debartan/MiniDox/Minidox Ref Case Files/README.md

# Minidox Files!

The project has been coordinated from Geekhack
([thread here](https://geekhack.org/index.php?topic=89951.msg2435112#msg2435112)), 
and the group buy run through reddit.  The Geekhack link has reddit threads and related discussion.

Files are posted, Video below of me explaning how to put it together.

Assembly youtube video (https://youtu.be/ApG_g-MvKxE)

## Acrylic thicknesses:

* 9mm (~3/8") for High Profile

* 6mm (~1/4") for Upper and Lower Middles

* 3mm (1/8") for Bottom

## Tapping Middles
Either a 1/4"-20 (Imperial) or M6 (Metric) tap will work.
Holes are compatible with either.
My preferred cheap source is Shars.
Links for: [1/4-20](http://www.shars.com/products/cutting/taps/1-4-20nc-taper-hss-standard-hand-tap) and [M6](http://www.shars.com/products/cutting/taps/6x1-0-hss-metric-spiral-point-plug-tap)
The easiest and fastest way I've found to tap is to chuck the tap in a handdrill.  Run the tap forward into the hole (after it's been poked clean of acrylic) until the taper clears.  Usually, you can tell because the drill will run easier after it has completed the thread.  Release the trigger and let the drill stop, then reverse out.  The important thing to remember when tapping is ** keep the tap perpendicular the workpiece! ** I've found keeping in the acrylic stock helps to prevent the middles from snapping or bending too much.

## Tapping High Profiles
It's similar, but a bit trickier because the holes are a lot smaller.
An M2 tap [like this one](http://www.shars.com/products/cutting/taps/m2-x-40-d3-2-flute-spiral-point-plug-tap) is what you'll need.  Make sure the hole is clear, and follow the same proceedure as above. Be careful, as the flute lenght is only a little longer than the acrylic in most cases.
Also of note is how for laser cuttering, it's important to get the hole very close to the needed dimension.  In my earlier testing, telling a laser to cut the right .063" (1.6mm) without cutter compensation made the hole too large for the screw to bite in after tapping.  What I did afterward was undersized the holes in CAD to .055" which worked most of the time.  In some cases, there was still some issues with slippage.  In that case, a little glue in the hole right before you stick the screw in can help.

## Ordering hardware

I've attached my "Assembly Counting" sheets, which are a packing list or the full acrylic or double plate case hardware packs. In the group buy, these came in little ziplok baggies.  The lists include the [McMaster Carr](https://www.mcmaster.com/#) part numbers for what I used.  If you want to make your own, they are probably your best source.  The one exception are the metric tenting screws, which I got from [Allen Fasteners](http://www.allensfasteners.com/detail.asp?Product_ID=70000).

## Plastidipping

Each tenting screw has been plastidipped for skid prevention.  The process is pretty simple, buy the can, dip the screw up until about the square part of neck, and have it dry vertically.  I used the side flaps of a box with a 1/4" hole drilled in them to support the screws.  One coat was plenty thick in my experience.
