debartan/MiniDox/CAD/Renders/Case_Render.JPG

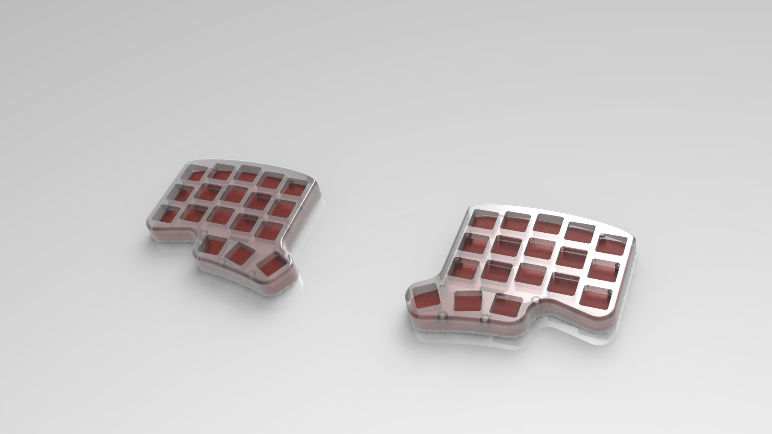
CAD/Renders/Case_Render.JPG
