debartan/MiniDox/CAD/Renders/Case_Render_wCaps.JPG

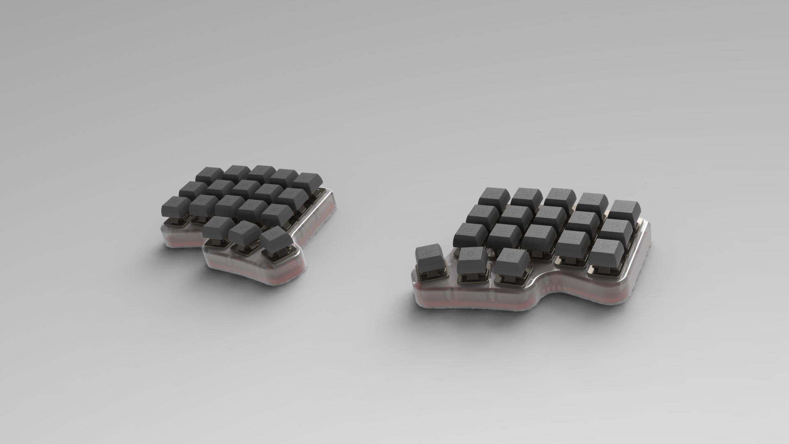
CAD/Renders/Case_Render_wCaps.JPG
