debartan/MiniDox/CAD/Renders/Case_Render_woCaps.JPG

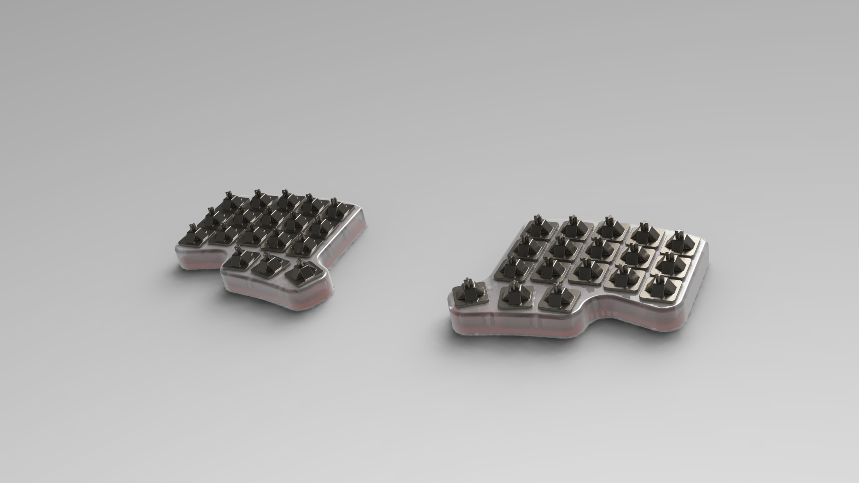
CAD/Renders/Case_Render_woCaps.JPG
