debartan/MiniDox/CAD/STL/FullAssembly - ControllerClipBot-1.STL

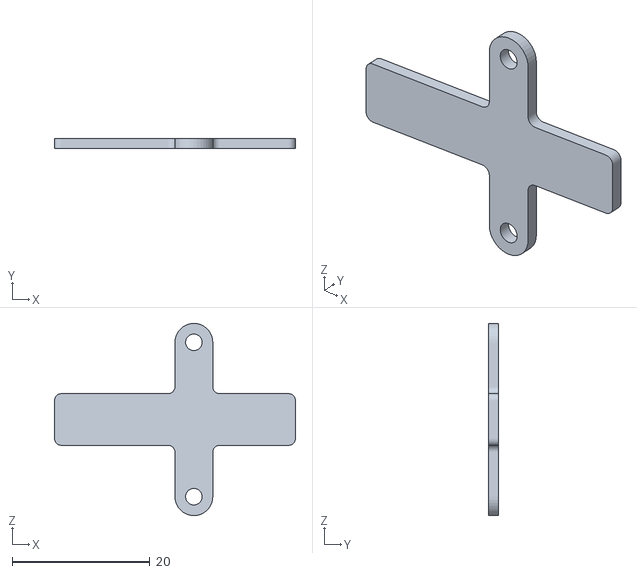
[picture p4: CAD file, 2021-05-11]
CAD/STL/FullAssembly - ControllerClipBot-1.STL
35.0 x 1.50 x 27.9
