debartan/MiniDox/CAD/Test Prints/ControllerFit.SLDASM

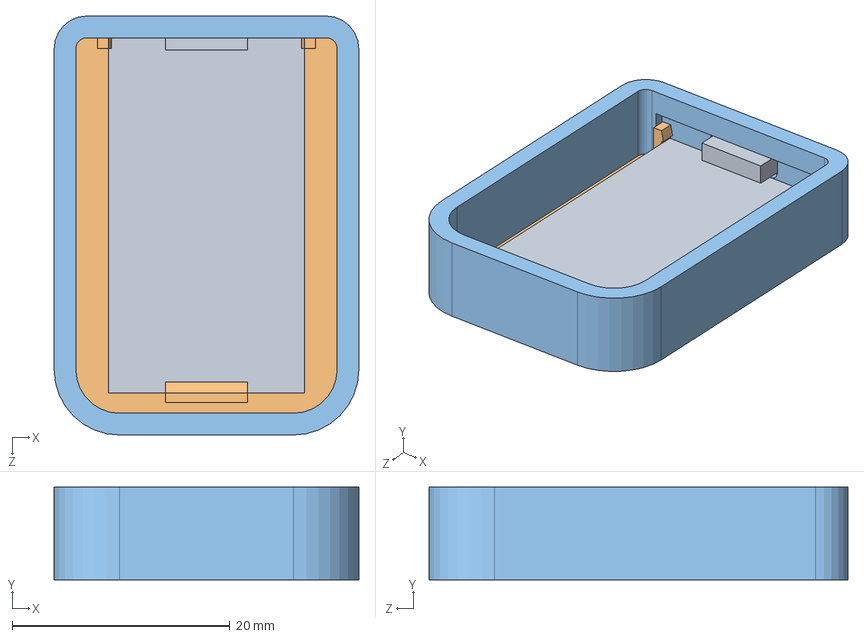
[picture p5: CAD file, 2021-05-11]
CAD/Test Prints/ControllerFit.SLDASM
28.0 x 8.50 x 38.5 mm
Microcontroller
Base^ControllerFit
Housing^ControllerFit
