debartan/MiniDox/CAD/STL/FullAssembly - ControllerClipTop-1.STL

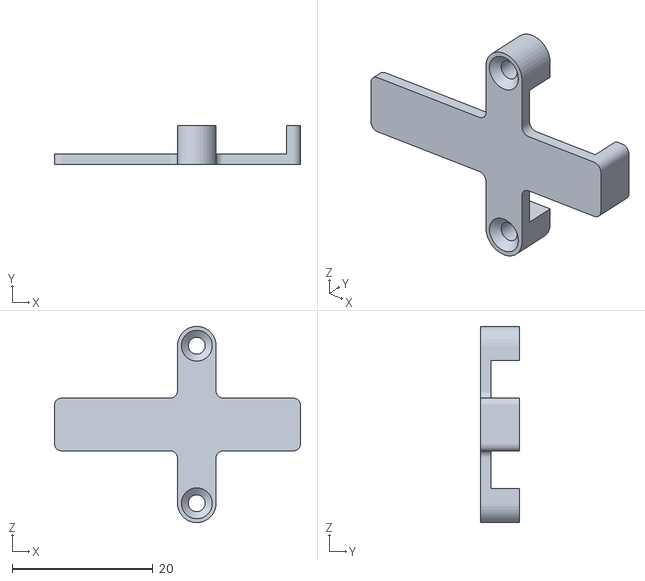
[picture p6: CAD file, 2021-05-11]
CAD/STL/FullAssembly - ControllerClipTop-1.STL
35.0 x 5.50 x 27.9
