debartan/MiniDox/CAD/Test Prints/USBFit.SLDASM

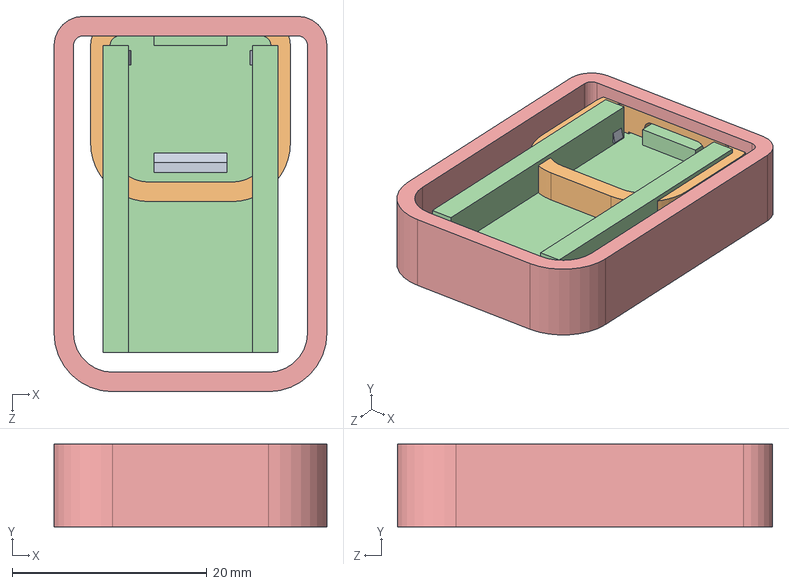
[picture p7: CAD file, 2021-05-11]
CAD/Test Prints/USBFit.SLDASM
28.0 x 8.50 x 38.5 mm
Base^USBFit
Housing^USBFit
USB
