debartan/MiniDox/CAD/STL/FullAssembly - Backplate-5.STL

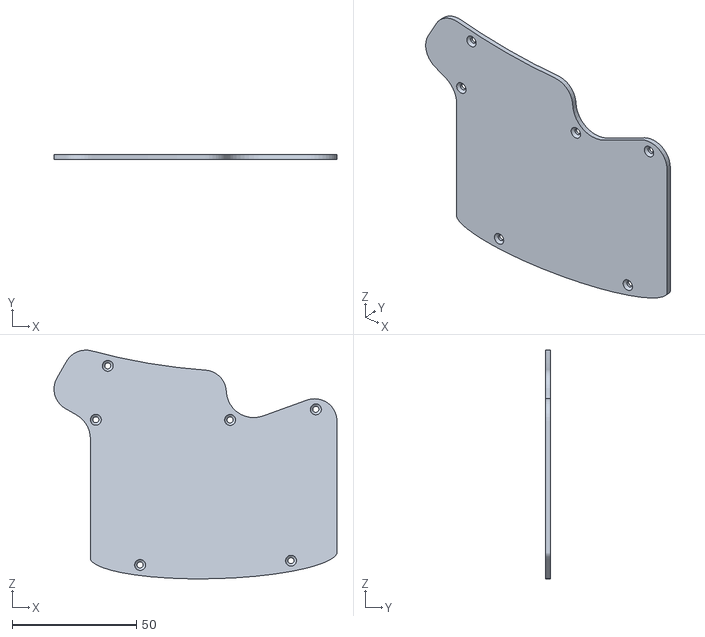
[picture p8: CAD file, 2021-05-11]
CAD/STL/FullAssembly - Backplate-5.STL
113.8 x 2.00 x 92.0
