debartan/MiniDox/CAD/STL/FullAssembly - MirrorControllerClipBot-3.STL

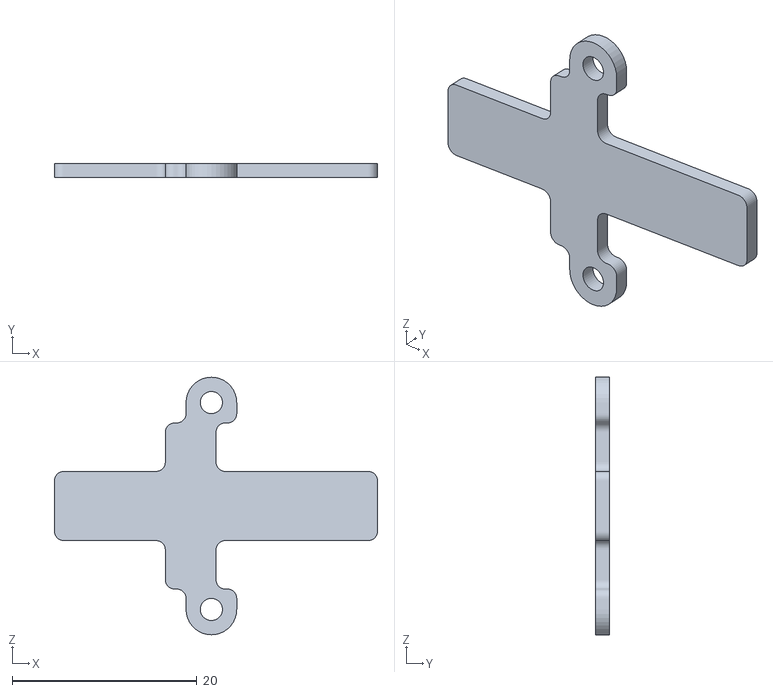
[picture p9: CAD file, 2021-05-11]
CAD/STL/FullAssembly - MirrorControllerClipBot-3.STL
35.0 x 1.50 x 27.9
