debartan/MiniDox/CAD/FullAssembly.SLDASM

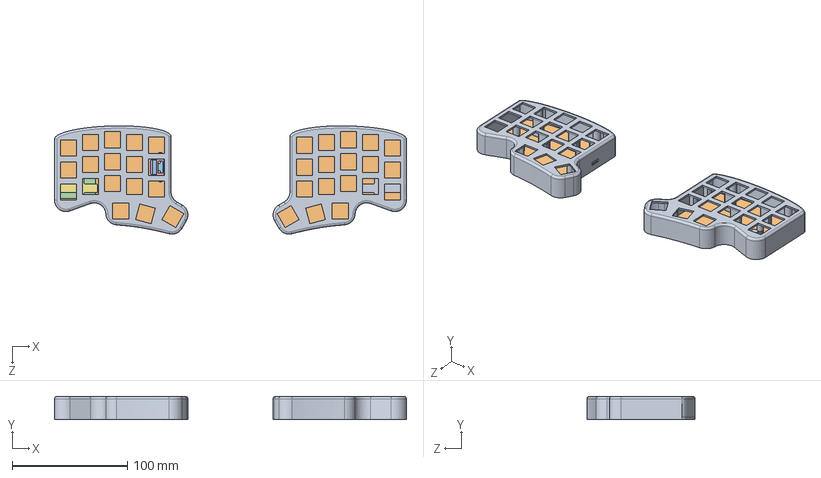
[picture p10: CAD file, 2021-05-11]
CAD/FullAssembly.SLDASM
305.5 x 20.0 x 94.0 mm
Plate x 2
Backplate x 2
USB
Microcontroller
USBClipBot
USBClipTop
ControllerClipBot
ControllerClipTop
MirrorControllerClipBot
MirrorControllerClipTop
