debartan/MiniDox/CAD/STL/FullAssembly - Plate-1.STL

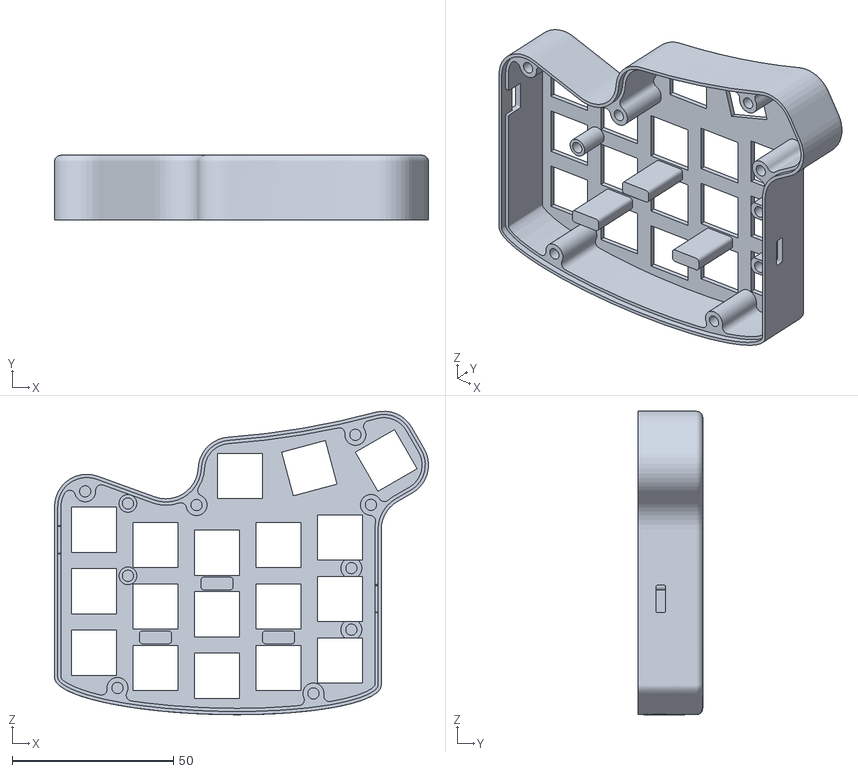
[picture p11: CAD file, 2021-05-11]
CAD/STL/FullAssembly - Plate-1.STL
115.8 x 20.0 x 94.0
