debartan/MiniDox/Minidox Ref Case Files/Full Acrylic Case.stp

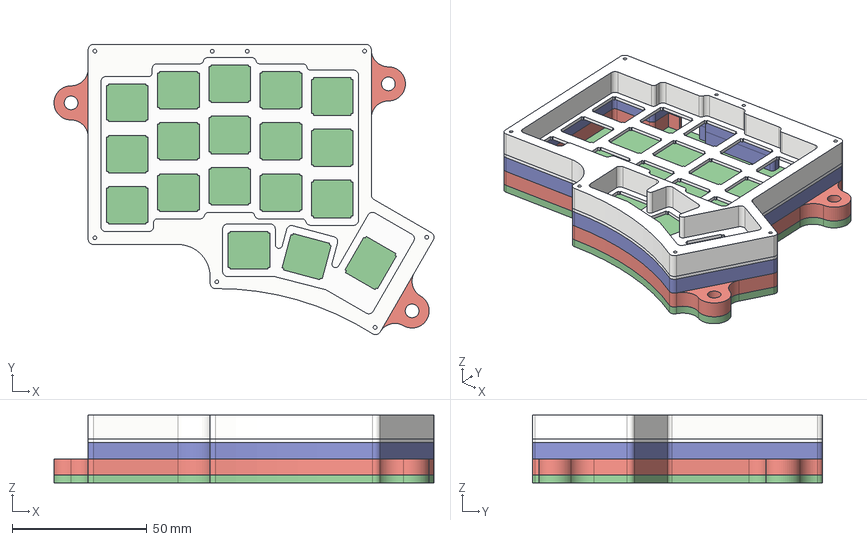
[picture p12: CAD file, 2021-04-21]
Minidox Ref Case Files/Full Acrylic Case.stp
141.3 x 107.9 x 25.3 mm
Top Plate PCB FIXED v2
Mid to be tapped
Bottom
Mid
Hi Prof to be Tapped
