debartan/MiniDox/CAD/STL/FullAssembly - USBClipBot-1.STL

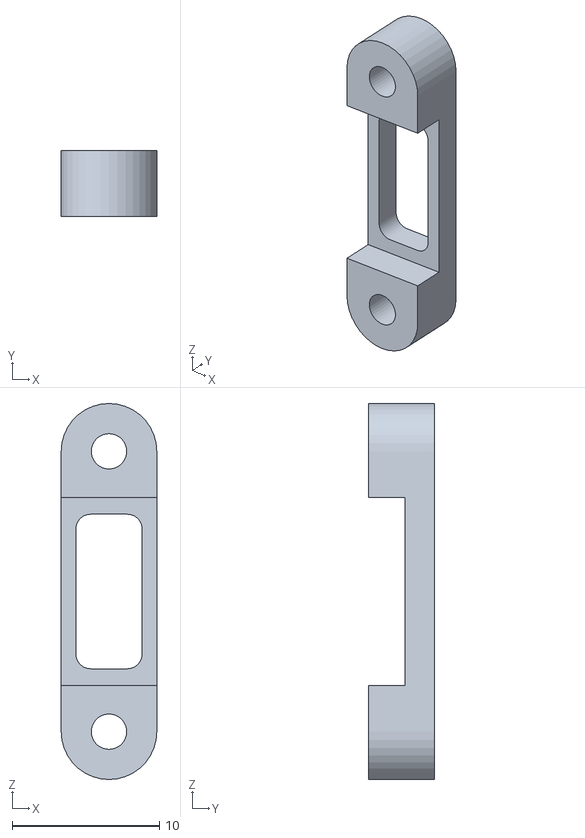
[picture p13: CAD file, 2021-05-11]
CAD/STL/FullAssembly - USBClipBot-1.STL
6.50 x 4.50 x 25.5
