debartan/MiniDox/CAD/STL/FullAssembly - USBClipTop-1.STL

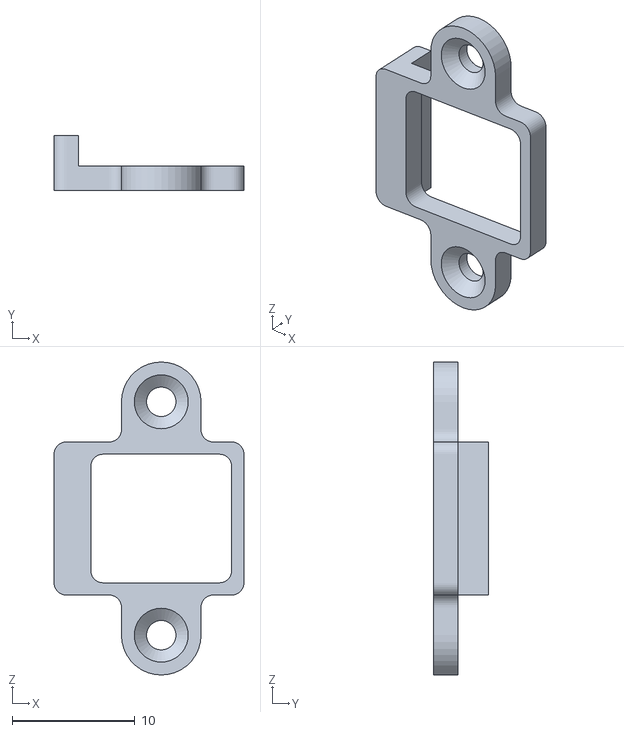
[picture p14: CAD file, 2021-05-11]
CAD/STL/FullAssembly - USBClipTop-1.STL
15.5 x 4.50 x 25.5
