debartan/MiniDox/CAD/KeycapCorner.SLDPRT

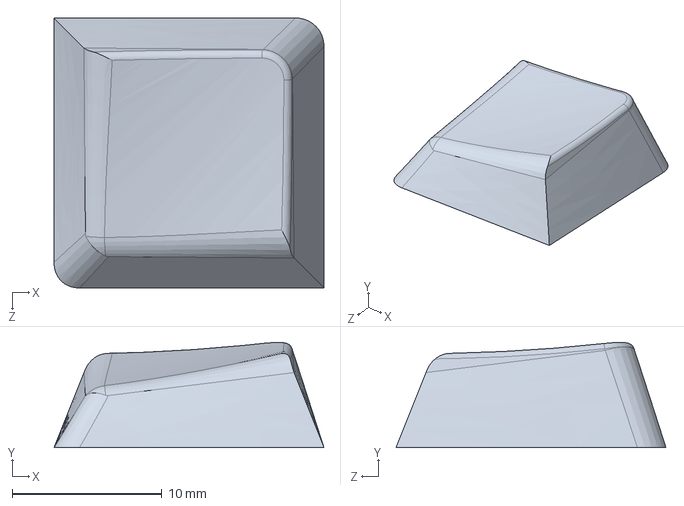
[picture p15: CAD file, 2021-05-21]
CAD/KeycapCorner.SLDPRT
18.0 x 7.01 x 18.0 mm
