debartan/MiniDox/CAD/Test Prints/STL/Electronics/ControllerFit - Base^Assem1-1.STL

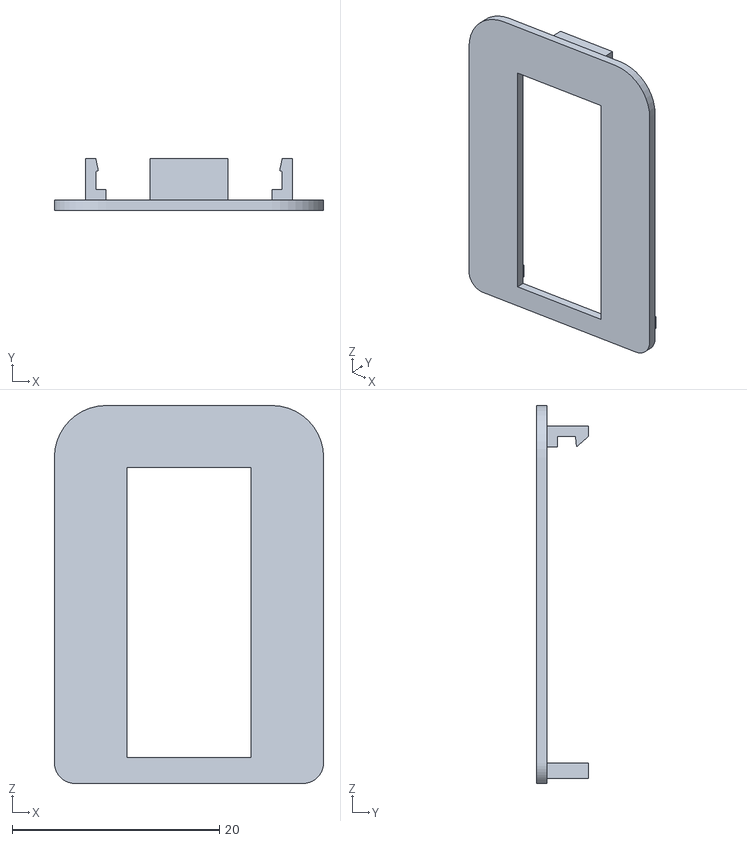
[picture p16: CAD file, 2021-05-11]
CAD/Test Prints/STL/Electronics/ControllerFit - Base^Assem1-1.STL
26.0 x 5.00 x 36.5
