debartan/MiniDox/CAD/Test Prints/STL/Inserts/KeyHole_ThreadedInsert_1-5mm.STL

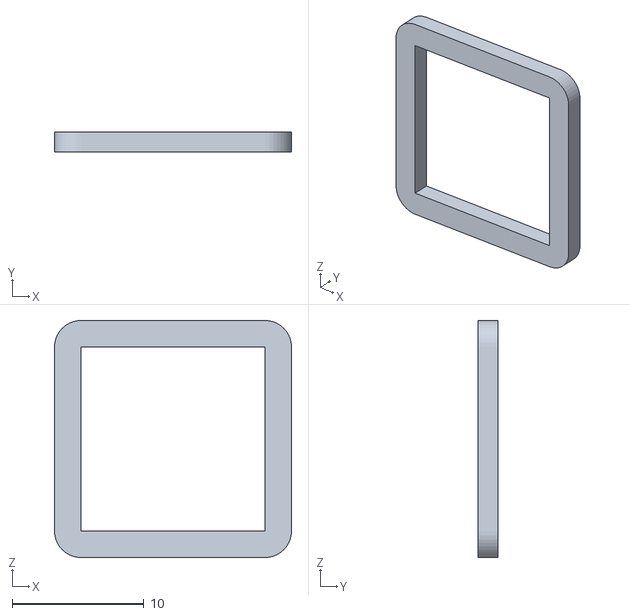
[picture p17: CAD file, 2021-04-21]
CAD/Test Prints/STL/Inserts/KeyHole_ThreadedInsert_1-5mm.STL
18.0 x 1.50 x 18.0
