debartan/MiniDox/Minidox Ref Case Files/Minidox Plate.stp

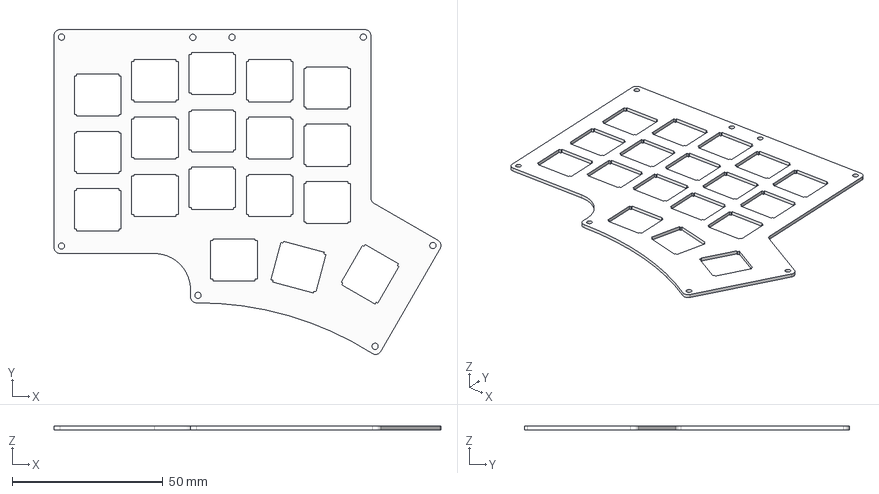
[picture p18: CAD file, 2021-04-21]
Minidox Ref Case Files/Minidox Plate.stp
128.6 x 107.9 x 1.27 mm
