debartan/MiniDox/CAD/Keycap10deg.SLDPRT

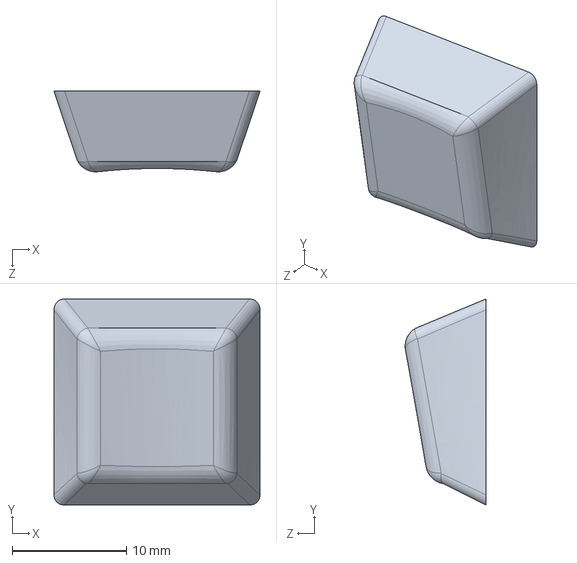
[picture p19: CAD file, 2021-05-21]
CAD/Keycap10deg.SLDPRT
18.0 x 18.0 x 7.06 mm
