debartan/MiniDox/CAD/Test Prints/STL/Electronics/ControllerFit - Housing^ControllerFit-1.STL

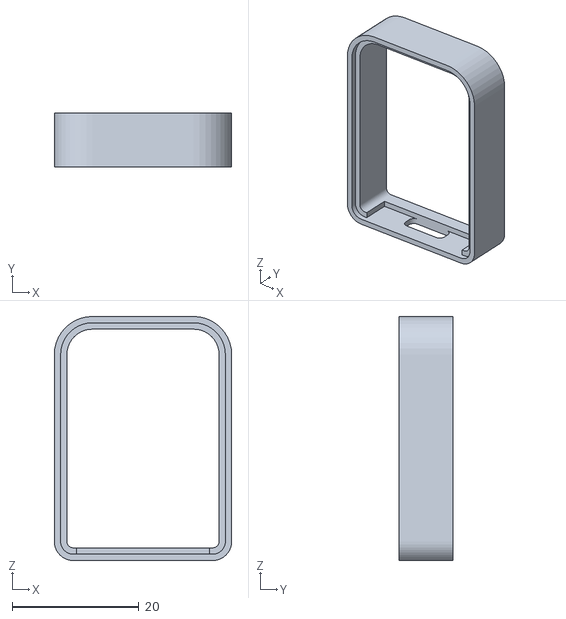
[picture p20: CAD file, 2021-04-21]
CAD/Test Prints/STL/Electronics/ControllerFit - Housing^ControllerFit-1.STL
28.0 x 8.50 x 38.5
