debartan/MiniDox/CAD/Test Prints/STL/Inserts/HoleTest.STL

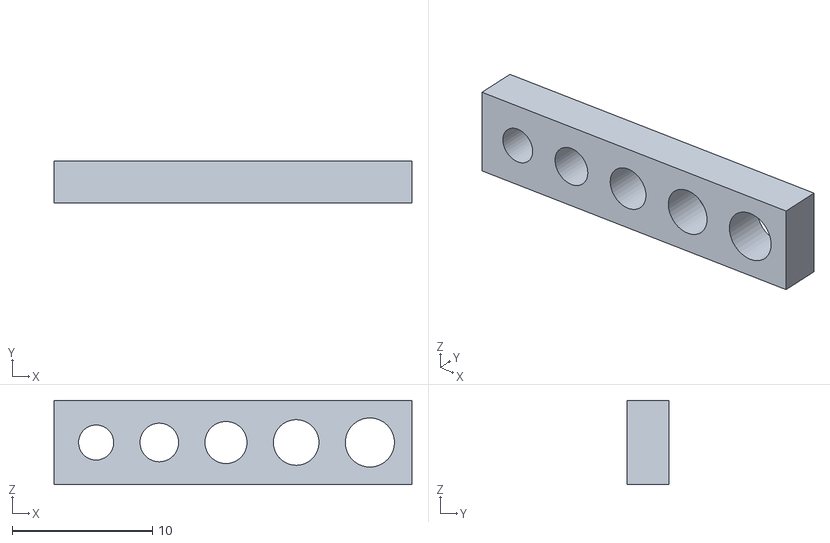
[picture p21: CAD file, 2021-04-21]
CAD/Test Prints/STL/Inserts/HoleTest.STL
25.5 x 3.00 x 6.00
