debartan/MiniDox/Minidox Ref Case Files/3D Magnet left.stl

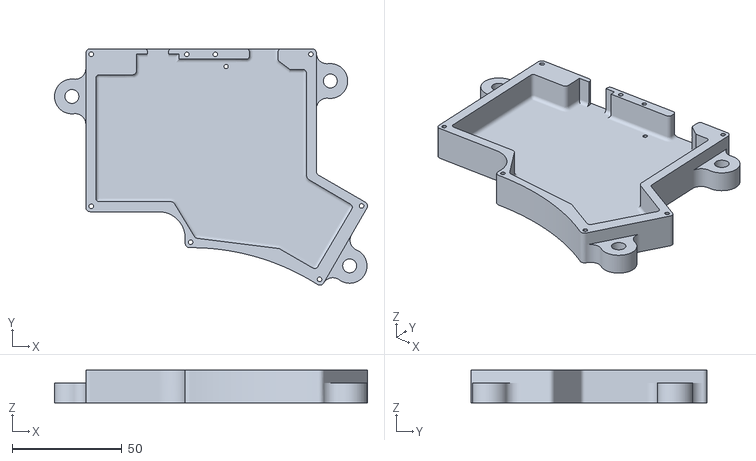
[picture p22: CAD file, 2021-04-21]
Minidox Ref Case Files/3D Magnet left.stl
142.8 x 107.9 x 15.0
