debartan/MiniDox/CAD/Keycap0deg.SLDPRT

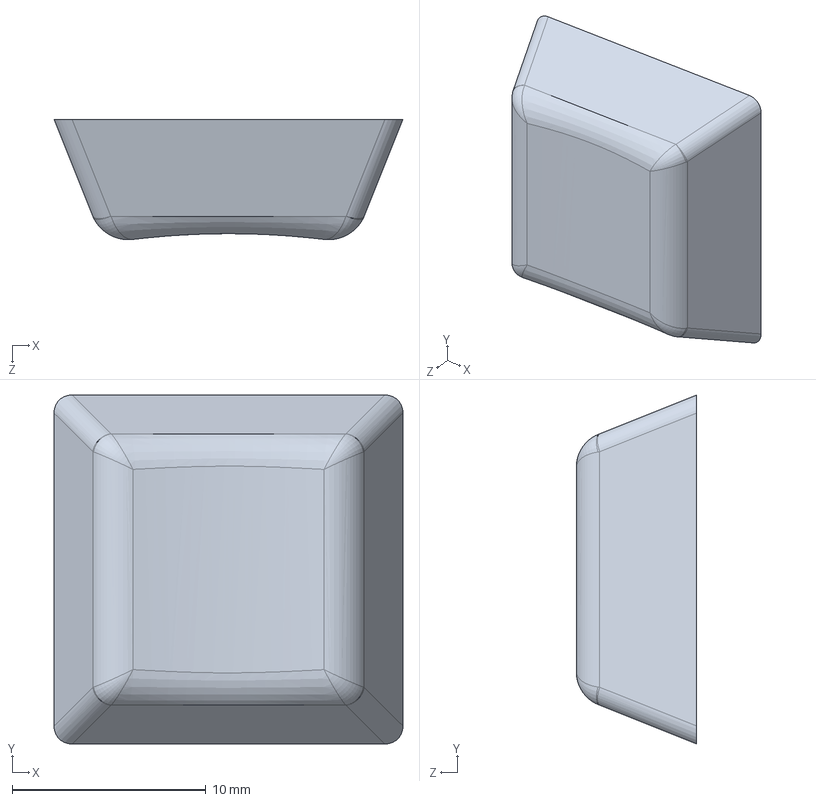
[picture p23: CAD file, 2021-05-21]
CAD/Keycap0deg.SLDPRT
18.0 x 18.0 x 6.21 mm
