debartan/MiniDox/CAD/Test Prints/KeyHole_ThreadedInsert.SLDPRT

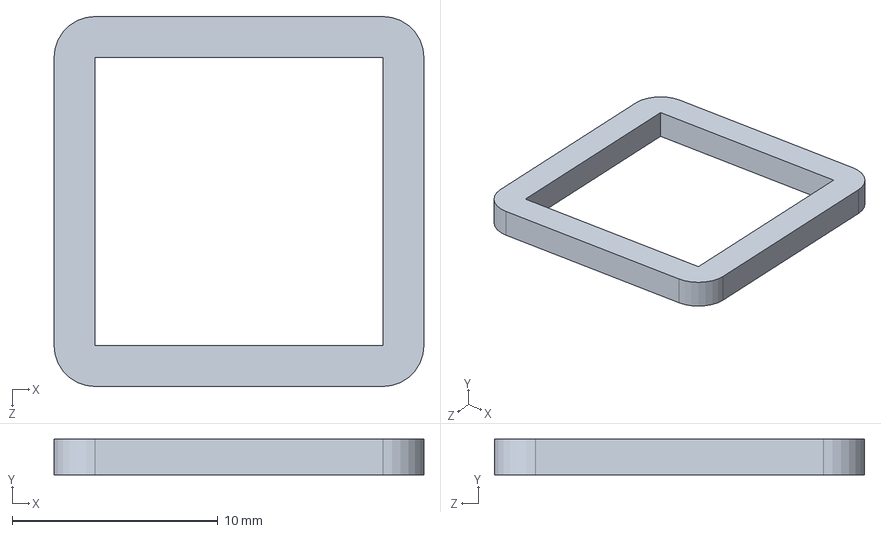
[picture p24: CAD file, 2021-04-21]
CAD/Test Prints/KeyHole_ThreadedInsert.SLDPRT
18.0 x 1.75 x 18.0 mm
