debartan/MiniDox/Minidox Ref Case Files/3D Printable Case.stp

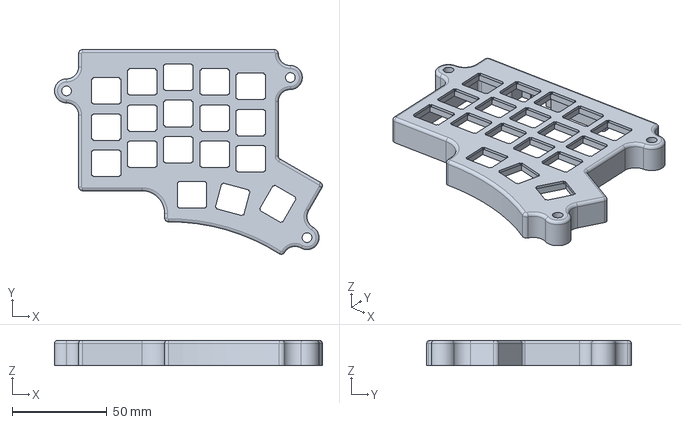
[picture p25: CAD file, 2021-04-21]
Minidox Ref Case Files/3D Printable Case.stp
141.3 x 107.9 x 13.3 mm
