debartan/MiniDox/CAD/Test Prints/HoleTest.SLDPRT

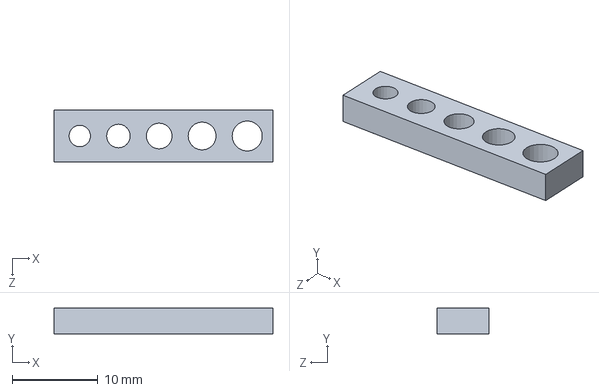
[picture p26: CAD file, 2021-04-21]
CAD/Test Prints/HoleTest.SLDPRT
25.5 x 3.00 x 6.00 mm
