debartan/MiniDox/CAD/Test Prints/STL/Inserts/KeyHole_ThreadedInsert_3mm.STL

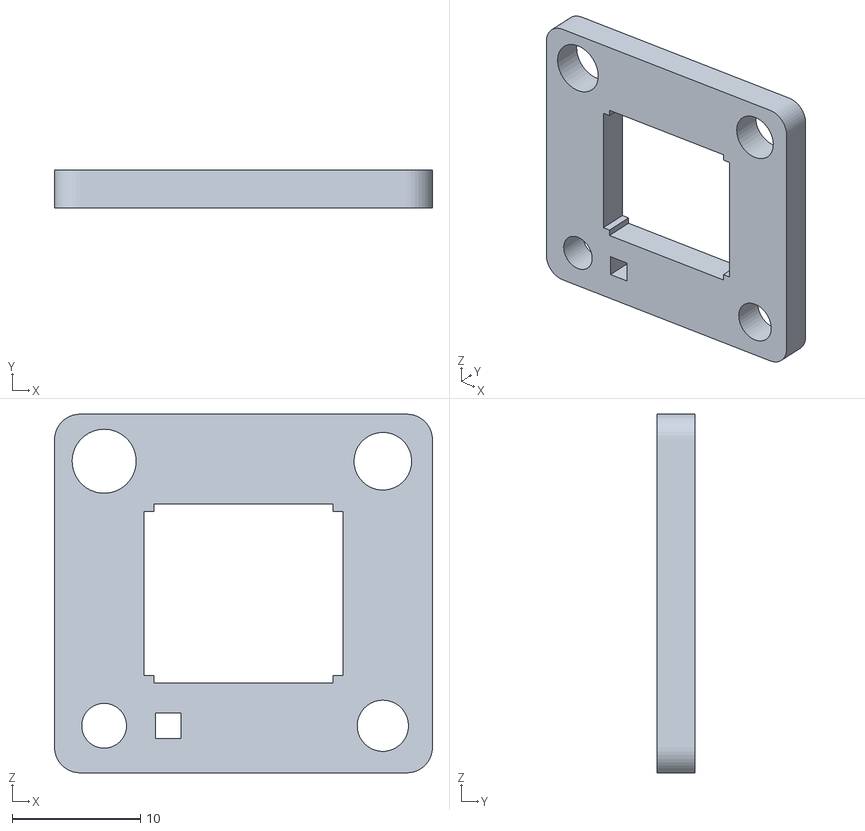
[picture p27: CAD file, 2021-04-21]
CAD/Test Prints/STL/Inserts/KeyHole_ThreadedInsert_3mm.STL
29.5 x 3.00 x 28.0
