debartan/MiniDox/CAD/Test Prints/STL/Inserts/KeyHole_ThreadedInsert_2mm.STL

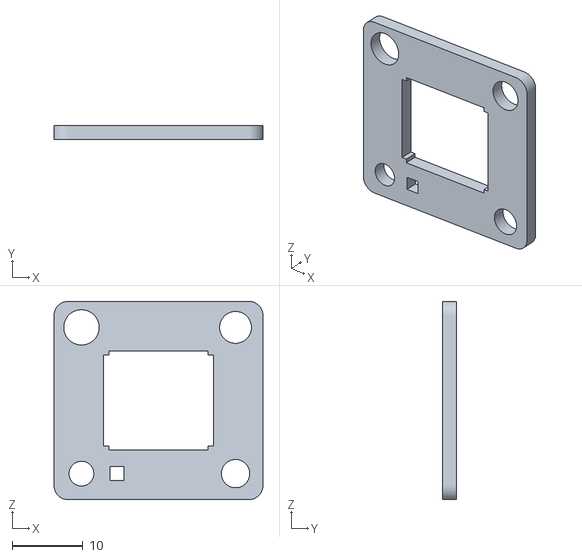
[picture p28: CAD file, 2021-04-21]
CAD/Test Prints/STL/Inserts/KeyHole_ThreadedInsert_2mm.STL
29.5 x 2.00 x 28.0
