debartan/MiniDox/Minidox Ref Case Files/Bottom.dxf

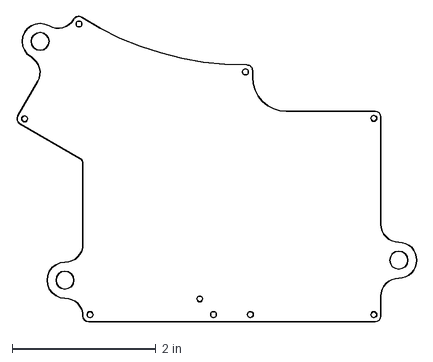
[picture p29: CAD file, 2021-04-21]
Minidox Ref Case Files/Bottom.dxf
5.57 x 4.25 in
