debartan/MiniDox/CAD/Test Prints/STL/Inserts/KeyHole_ThreadedInsert_2-5mm.STL

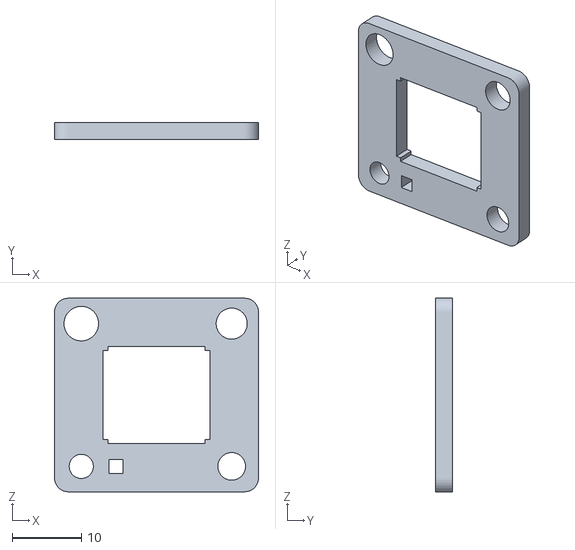
[picture p30: CAD file, 2021-04-21]
CAD/Test Prints/STL/Inserts/KeyHole_ThreadedInsert_2-5mm.STL
29.5 x 2.50 x 28.0
