debartan/MiniDox/Minidox Ref Case Files/Lower Middle (tapped).dxf

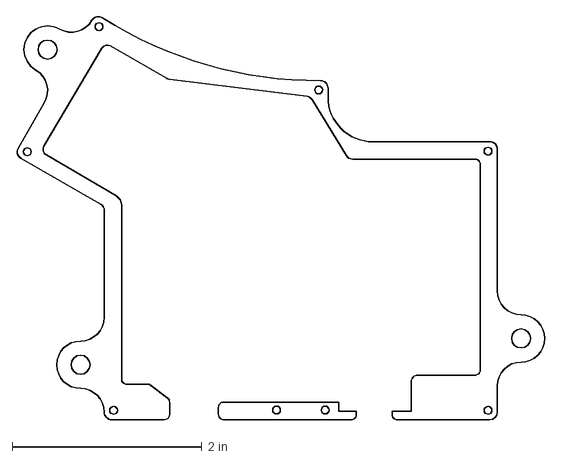
[picture p31: CAD file, 2021-04-21]
Minidox Ref Case Files/Lower Middle (tapped).dxf
5.57 x 4.25 in
