debartan/MiniDox/CAD/Microcontroller.SLDPRT

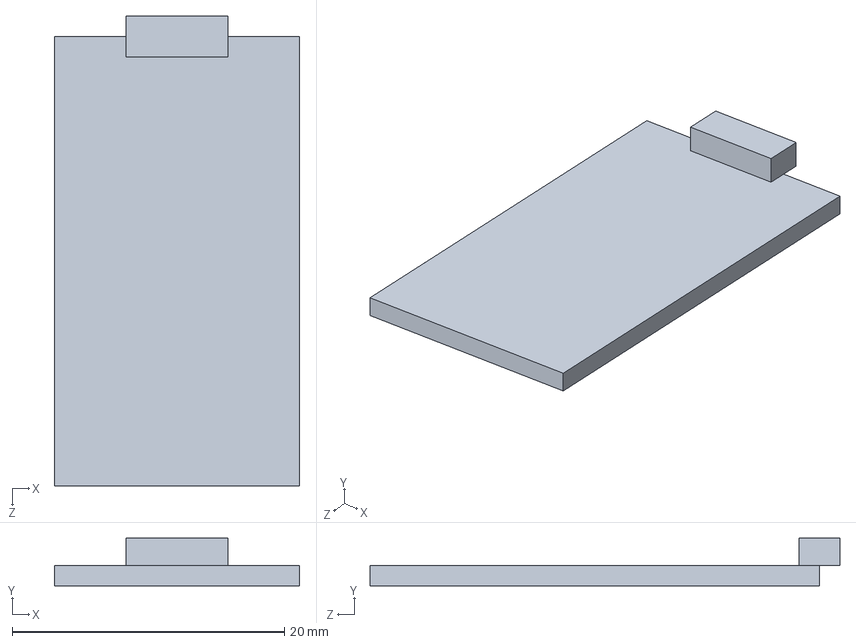
[picture p32: CAD file, 2021-05-11]
CAD/Microcontroller.SLDPRT
18.0 x 3.50 x 34.5 mm
