debartan/MiniDox/Minidox Ref Case Files/Upper MIddle.dxf

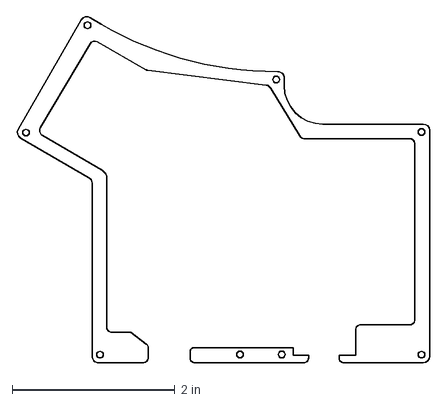
[picture p33: CAD file, 2021-04-21]
Minidox Ref Case Files/Upper MIddle.dxf
5.07 x 4.25 in
