debartan/MiniDox/CAD/Plate.sldprt

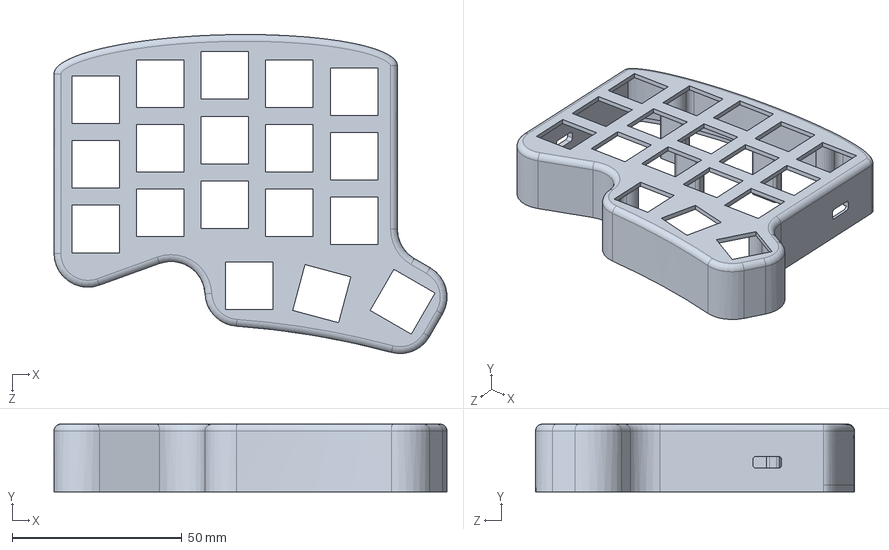
[picture p34: CAD file, 2021-05-11]
CAD/Plate.sldprt
115.8 x 20.0 x 94.0 mm
