debartan/MiniDox/CAD/Keycap.SLDPRT

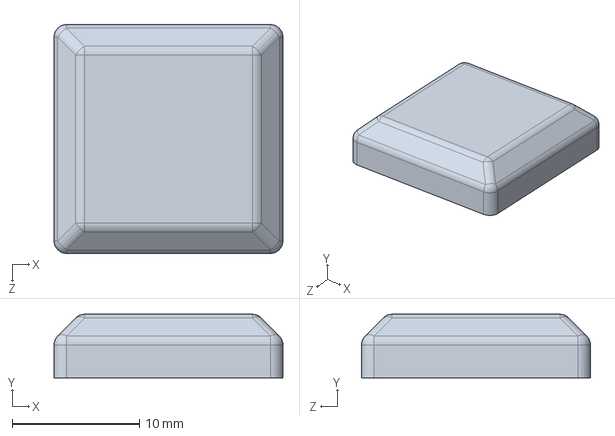
[picture p35: CAD file, 2021-05-11]
CAD/Keycap.SLDPRT
18.0 x 5.00 x 18.0 mm
