debartan/MiniDox/CAD/Key.SLDPRT

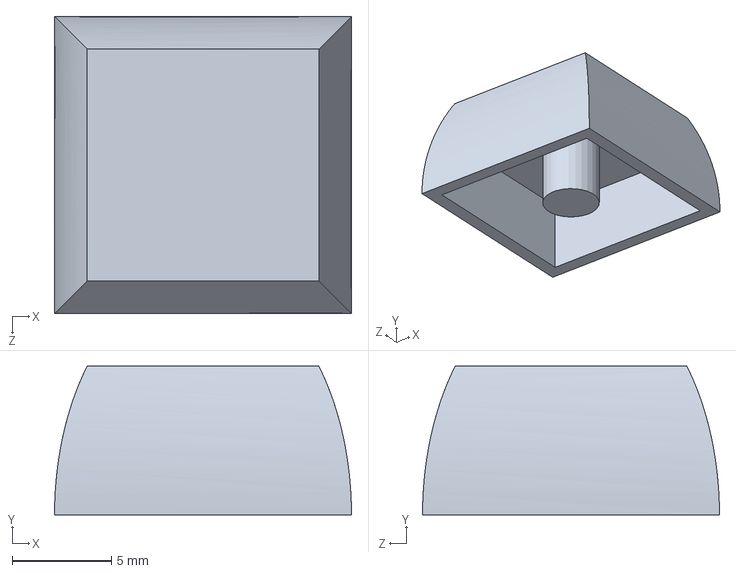
[picture p36: CAD file, 2021-04-21]
CAD/Key.SLDPRT
15.0 x 7.50 x 15.0 mm
