debartan/MiniDox/CAD/KeySwitch.SLDPRT

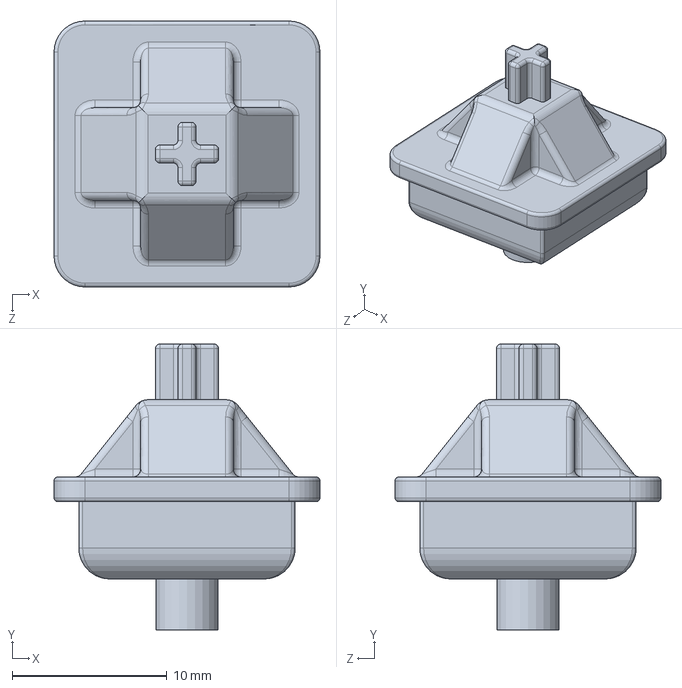
[picture p37: CAD file, 2021-04-21]
CAD/KeySwitch.SLDPRT
17.2 x 18.5 x 17.2 mm
