debartan/MiniDox/CAD/USB.SLDPRT

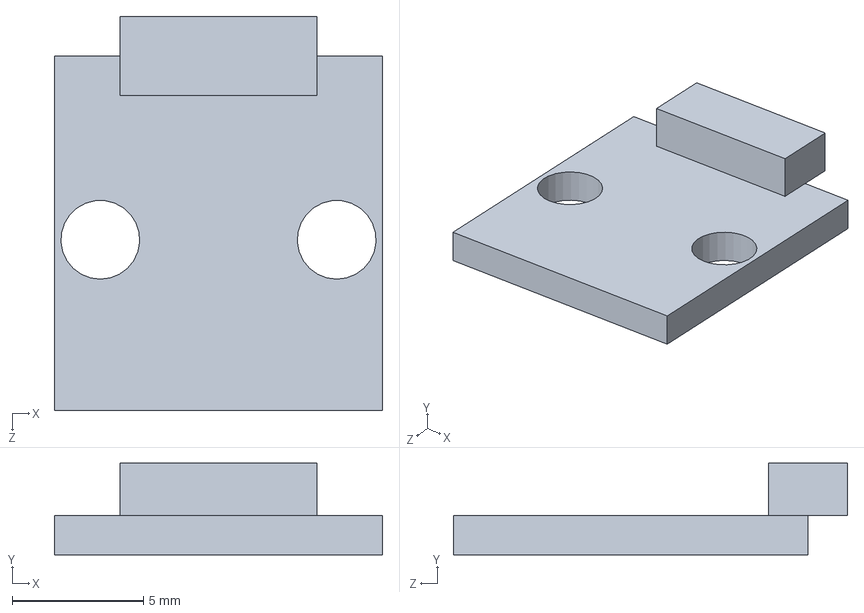
[picture p38: CAD file, 2021-04-21]
CAD/USB.SLDPRT
12.5 x 3.50 x 15.0 mm
