debartan/MiniDox/CAD/Minidox Plate.dxf

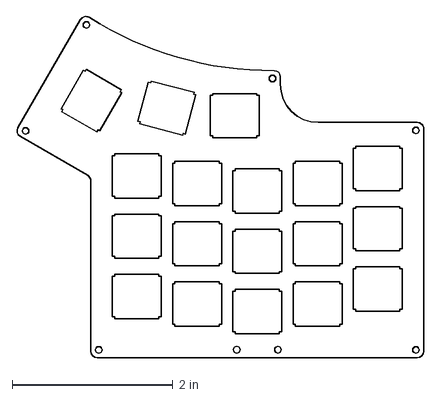
[picture p39: CAD file, 2021-04-21]
CAD/Minidox Plate.dxf
5.07 x 4.25 in
