debartan/MiniDox/(list of files, cad)

Other CAD files:
CAD/STL/FullAssembly - MirrorControllerClipTop-3.STL
CAD/STL/FullAssembly - Backplate-1.STL
CAD/STL/FullAssembly - Plate-5.STL
CAD/Test Prints/STL/Inserts/KeyHole_ThreadedInsert_1-75mm.STL
CAD/ControllerClipBot.SLDPRT
Minidox Ref Case Files/3D printable bottom right.stl
CAD/MirrorControllerClipBot.SLDPRT
CAD/Backplate.sldprt
CAD/USBClipTop.SLDPRT
Minidox Ref Case Files/3D Magnet right.stl
CAD/MirrorControllerClipTop.SLDPRT
Minidox Ref Case Files/3D printable bottom left.stl
CAD/ControllerClipTop.SLDPRT
CAD/USBClipBot.SLDPRT
CAD/STL/Keycap.STL
CAD/STL/Keycap0deg.STL
CAD/STL/Keycap10deg.STL
CAD/STL/KeycapCorner.STL
Minidox Ref Case Files/3D printable Case.stl
Minidox Ref Case Files/Full Acrylic Case.stl
