debartan/MiniDox/Minidox Ref Case Files/Assembly Counting - Double Plate Case.pdf

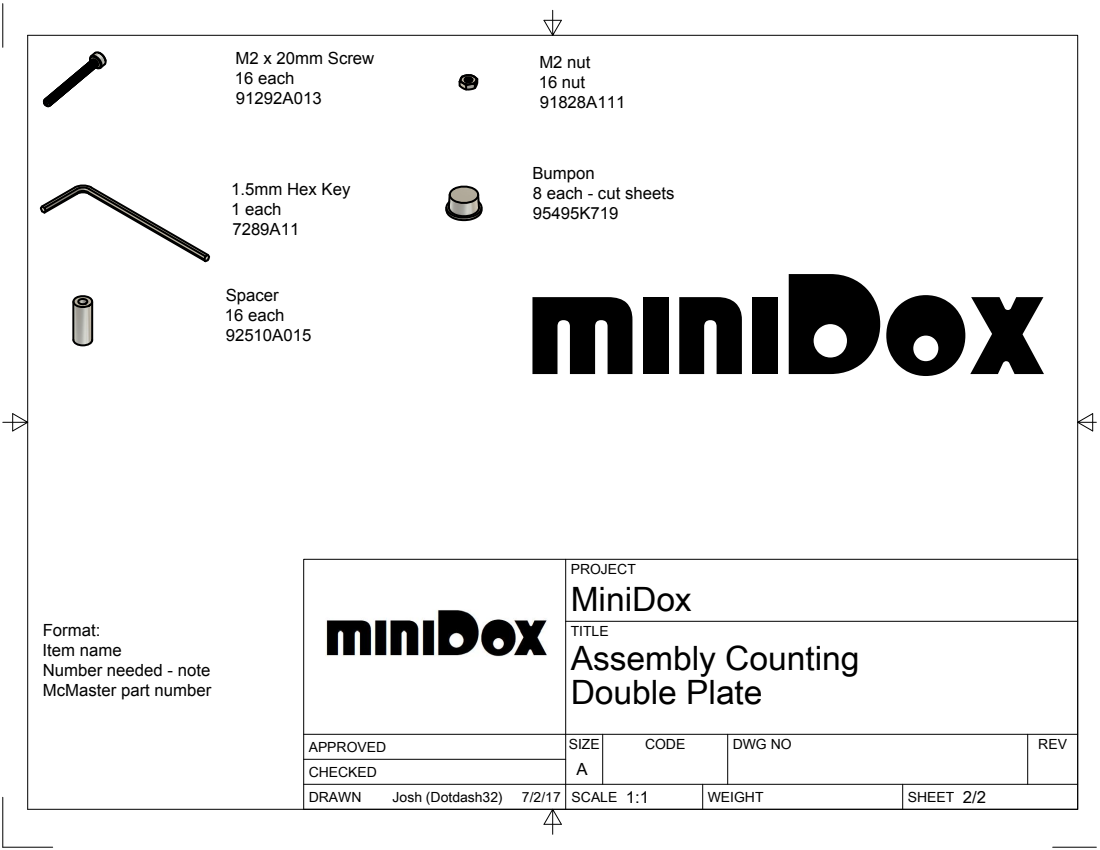
[picture p40: page 1]
SIZE; CODE; DWG NO; REV; Josh (Dotdash32); Double Plate; Assembly Counting; M2 x 20mm Screw 16 each; 1.5mm Hex Key 1 each; 16 each; M2 nut 16 nut; 8 each - cut sheets

Format:
Item name
Number needed - note
McMaster part number
