debartan/MiniDox/Minidox Ref Case Files/Assembly Counting - Full Acrylic Case.pdf

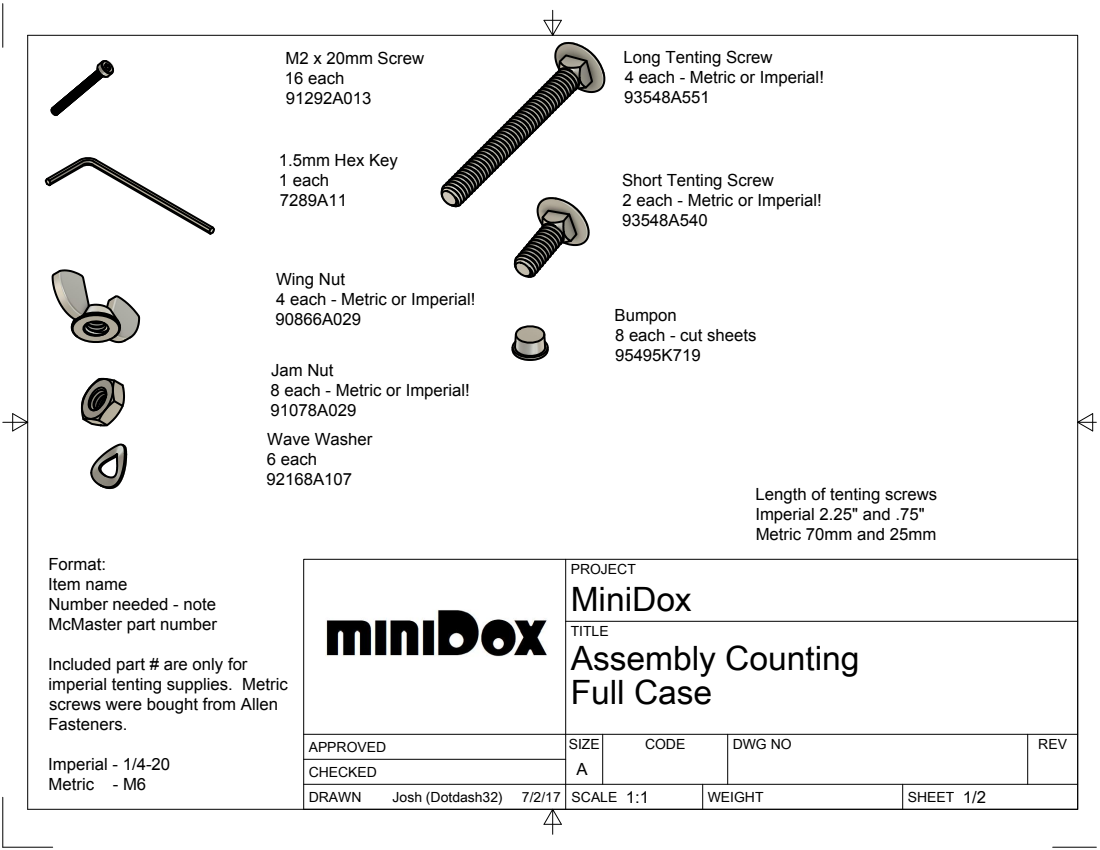
[picture p41: page 1]
SIZE; CODE; DWG NO; REV; Josh (Dotdash32); Full Case; Assembly Counting; M2 x 20mm Screw 16 each; 1.5mm Hex Key 1 each; 8 each - cut sheets; Imperial - 1/4-20 Metric - M6

Long Tenting Screw
4 each - Metric or Imperial!

Short Tenting Screw
2 each - Metric or Imperial!

Wing Nut

Jam Nut
8 each - Metric or Imperial!
Wave Washer
6 each

Length of tenting screws
Imperial 2.25" and .75"
Metric 70mm and 25mm

Format:
Item name
Number needed - note
McMaster part number

Included part # are only for
imperial tenting supplies. Metric
screws were bought from Allen
Fasteners.
