debartan/MiniDox/Minidox Ref Case Files/Minidox Plate.pdf

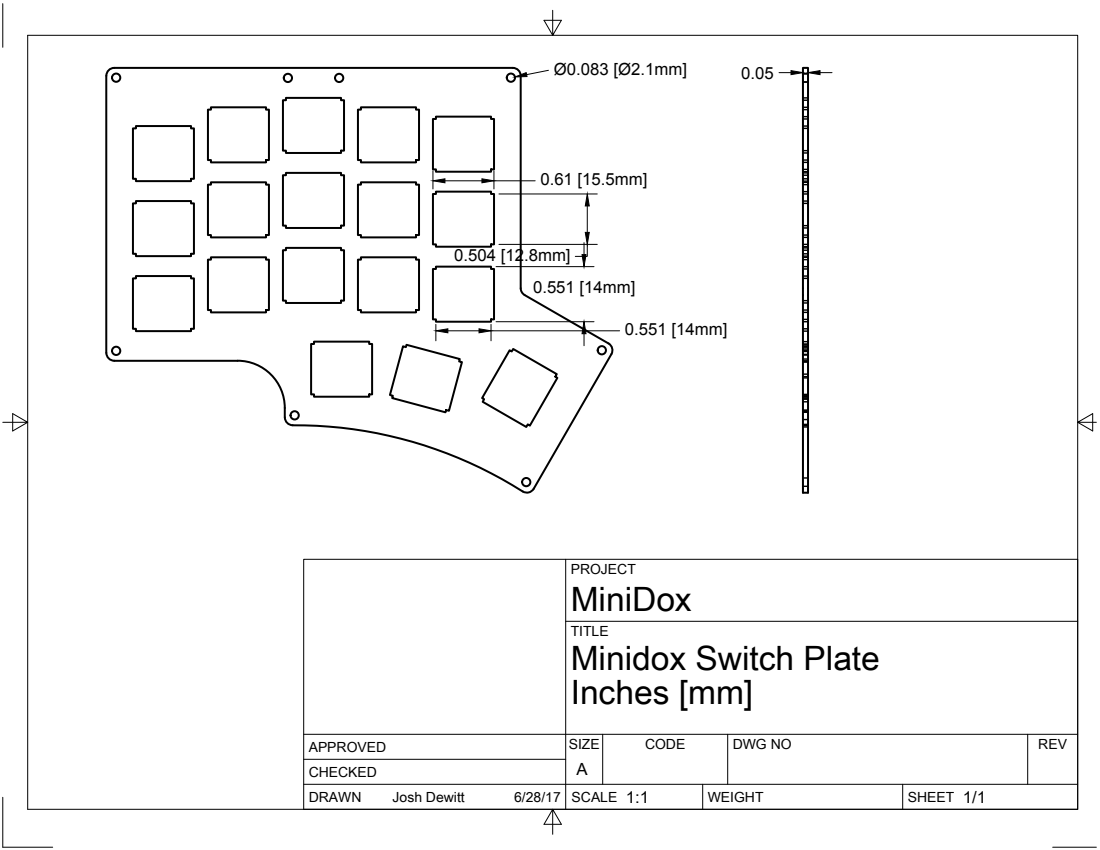
[picture p42: page 1]
SIZE; CODE; DWG NO; REV; Josh Dewitt

PROJECT
MiniDox
Minidox Switch Plate
Inches [mm]
