debartan/MiniDox/(commit log)

2021-04-21 First push
    pushing CAD that was originally on gdrive
    [3D Magnet left.stl, 3D Magnet right.stl, 3D Printable Case.stp, 3D printable Case.stl, 3D printable bottom left.stl, 3D printable bottom right.stl, Backplate.STL, Backplate.sldprt]
2021-05-11 misc changes
    [Backplate.STL, Backplate.sldprt, Case.SLDASM, ControllerClipBot.SLDPRT, ControllerClipTop.SLDPRT, ControllerFit - Base^Assem1-1.STL, ControllerFit.SLDASM, FullAssembly - Backplate-1.STL]
